DelMellomida/kai/requirements.lock.txt

# Generated by scripts/freeze_requirements.sh on 2026-08-07T12:01:05+08:00
# Host: Linux 5.15.148-tegra aarch64  |  Python 3.10.12
#
# ⚠️  Lines marked [JETSON-BUILT] must NOT be reinstalled from PyPI — they are either
#     hand-built with CUDA or provided by JetPack. Restoring them from this file with a
#     plain 'pip3 install -r' will give you a CPU-only build.
#
absl-py==2.4.0
annotated-doc==0.0.4
anyio==4.13.0
appdirs==1.4.4
apturl==0.5.2
async-timeout==5.0.1
attrs==21.2.0
av==17.1.0
backports.asyncio.runner==1.2.0
bcrypt==3.2.0
beniget==0.4.1
bleak==3.0.2
blinker==1.9.0
bluez_peripheral==0.2.0a5
Brlapi==0.8.3
Brotli==1.0.9
certifi==2026.6.17
cffi==2.0.0
chardet==4.0.0
charset-normalizer==3.4.7
click==8.4.1
colorama==0.4.4
coloredlogs==15.0.1
coverage==7.14.1
cpuset==1.6
cryptography==3.4.8
ctranslate2==4.8.0
cupshelpers==1.0
cycler==0.11.0
Cython==3.2.5
dbus-fast==5.0.22
dbus-python==1.2.18
decorator==4.4.2
defer==1.0.6
distro==1.7.0
distro-info==1.1+ubuntu0.2
dnspython==2.1.0
duplicity==0.8.21
exceptiongroup==1.3.1
fastembed==0.8.0
fasteners==0.14.1
faster-whisper==1.2.1
filelock==3.29.0
Flask==3.1.3
flatbuffers==25.12.19
fonttools==4.29.1
fs==2.4.12
fsspec==2026.4.0
future==0.18.2
gast==0.5.2
gpg==1.16.0
h11==0.16.0
hf-xet==1.5.0
httpcore==1.0.9
httplib2==0.20.2
httpx==0.28.1
huggingface_hub==1.18.0
humanfriendly==10.0
idna==3.3
importlib-metadata==4.6.4
iniconfig==2.3.0
itsdangerous==2.2.0
jax==0.6.2
jaxlib==0.6.2
jeepney==0.7.1
jetson-stats==4.3.2    # [JETSON-BUILT] do not reinstall from PyPI
Jetson.GPIO==2.1.7
Jinja2==3.1.6
joblib==1.5.3
keyring==23.5.0
kiwisolver==1.3.2
language-selector==0.1
launchpadlib==1.10.16
lazr.restfulclient==0.14.4
lazr.uri==1.0.6
lockfile==0.12.2
loguru==0.7.3
louis==3.20.0
lxml==4.8.0
lz4==3.1.3+dfsg
macaroonbakery==1.3.1
Mako==1.1.3
Markdown==3.3.6
markdown-it-py==4.2.0
MarkupSafe==3.0.3
matplotlib==3.5.1
mdurl==0.1.2
mediapipe==0.10.18
ml_dtypes==0.5.4
mmh3==5.2.1
monotonic==1.6
more-itertools==8.10.0
mpmath==1.3.0
networkx==3.4.2
numpy==1.26.4
oauthlib==3.2.0
olefile==0.46
onboard==1.4.1
onnxruntime==1.23.2
opencv-contrib-python==4.11.0.86
opencv-python==4.11.0.86
openwakeword==0.6.0
opt_einsum==3.4.0
packaging==26.2
pandas==1.3.5
paramiko==2.9.3
pathvalidate==3.3.1
pexpect==4.8.0
pillow==12.3.0
piper-tts==1.4.2
pluggy==1.6.0
ply==3.11
polars==1.41.2
polars-runtime-32==1.41.2
protobuf==4.25.9
psutil==7.2.2
ptyprocess==0.7.0
pvporcupine==4.0.3
py-spy==0.4.2
py_rust_stemmers==0.1.8
pycairo==1.20.1
pycparser==3.0
pycups==2.0.1
Pygments==2.20.0
PyGObject==3.42.1
PyJWT==2.3.0
pymacaroons==0.13.0
PyNaCl==1.5.0
PyOpenGL==3.1.5
pyparsing==2.4.7
pypdf==6.14.2
pyRFC3339==1.1
pyserial==3.5
pytest==9.0.3
pytest-asyncio==1.4.0
pytest-cov==7.1.0
pytest-mock==3.15.1
python-apt==2.4.0+ubuntu4.1
python-dateutil==2.8.1
python-dbusmock==0.27.5
python-debian==0.1.43+ubuntu1.1
python-dotenv==1.2.2
pythran==0.10.0
pytz==2022.1
pyxdg==0.27
PyYAML==5.4.1
requests==2.34.2
requests-toolbelt==0.9.1
rich==15.0.0
scikit-learn==1.7.2
scipy==1.15.3
SecretStorage==3.3.1
sentencepiece==0.2.1
# Editable install with no version control (sentient-face==0.1.0)
-e /home/devconph/Documents/sentient-face
shellingham==1.5.4
six==1.16.0
smbus2==0.6.1
sounddevice==0.5.5
sympy==1.13.1
systemd-python==234
tensorrt==10.3.0    # [JETSON-BUILT] do not reinstall from PyPI
tensorrt_dispatch==10.3.0    # [JETSON-BUILT] do not reinstall from PyPI
tensorrt_lean==10.3.0    # [JETSON-BUILT] do not reinstall from PyPI
threadpoolctl==3.6.0
tokenizers==0.23.1
tomli==2.4.1
torch @ file:///home/devconph/torch-2.5.0a0%2B872d972e41.nv24.08.17622132-cp310-cp310-linux_aarch64.whl    # [JETSON-BUILT] do not reinstall from PyPI
torchvision==0.20.0    # [JETSON-BUILT] do not reinstall from PyPI
tqdm==4.68.1
typer==0.25.1
typing_extensions==4.15.0
ubuntu-drivers-common==0.0.0
ubuntu-pro-client==8001
ufoLib2==0.13.1
ultralytics==8.4.57
ultralytics-thop==2.0.19
unicodedata2==14.0.0
urllib3==1.26.5
urwid==2.1.2
wadllib==1.3.6
webrtcvad==2.0.10
Werkzeug==3.1.8
xdg==5
xkit==0.0.0
zipp==1.0.0
