DelMellomida/kai/documents/devcon_faq_rag.md

# DEVCON PH — Knowledge Base (RAG)

---
id: about-what-is
section: About DEVCON
synonyms: [what is DEVCON, DEVCON meaning, who are you, organization overview, mission, vision, purpose, goal, what is DEVCON trying to achieve, what DEVCON stands for]
---
**Q: What is DEVCON Philippines?**
A: DEVCON (Developers Connect), registered as DevConnect Philippines Inc., is a non-profit and the largest volunteer community of software developers and tech future makers in the Philippines. Its vision is a technology-empowered Philippines for all, and its mission is to build vibrant developer communities empowered with knowledge, open-source software, and opportunities to solve impactful national problems.

---
id: about-history
section: About DEVCON
synonyms: [origin, founding, how it began, PSIA, first event]
---
**Q: When and how did DEVCON start?**
A: DEVCON began in 2009 as a project of the Philippine Software Industry Association (PSIA), piloting with DEVCON Visayas at the TechBar in Cebu City. It grew into a ten-city Next Wave Cities tour, partnered with the Philippine Society of IT Educators (PSITE) to reach students, and later registered with the SEC as a non-profit.

---
id: about-scale
section: About DEVCON
synonyms: [size, reach, how many participants, total members]
---
**Q: How big is DEVCON?**
A: DEVCON has reached over 60,000 participants since June 2009 through free conferences, summits, hackathons, workshops, and meetups. It operates active chapters nationwide across Luzon, Visayas, and Mindanao.

---
id: about-leadership
section: About DEVCON
synonyms: [who leads, head, CEO, in charge]
---
**Q: Who leads DEVCON?**
A: DEVCON's founder and president is Winston Damarillo.

---
id: about-anniversary
section: About DEVCON
synonyms: [this year, theme, 17 years, AIReadyPH]
---
**Q: What is DEVCON celebrating this year?**
A: DEVCON is marking its 17th anniversary under the theme "17 Years of DEVCON: Engineering an AI-Ready Nation" (#AIReadyPH). Its current focus is democratizing access to AI for all Filipinos.

---
id: about-online
section: About DEVCON
synonyms: [website, contact, links, social media, find you]
---
**Q: Where can I find DEVCON online?**
A: DEVCON is at devcon.ph, with chapters listed at devcon.ph/chapters and its community platform at devcon.plus.

---
id: chapters-count
section: Chapters
synonyms: [how many chapters, number of chapters, how many active, chapter count, how many branches, ilan ang chapters]
---
**Q: How many chapters does DEVCON have?**
A: DEVCON has 9 active chapters — Metro Manila, Laguna, Legazpi, Pampanga, Cebu, Iloilo, Davao, Bukidnon, and Iligan — out of 12 in total. Bacolod, Bohol, and Cagayan de Oro (CDO) are currently inactive but retain volunteer-led communities.

---
id: chapters-locations
section: Chapters
synonyms: [where are chapters, cities, branches, active inactive]
---
**Q: Where are DEVCON's chapters?**
A: DEVCON runs active chapters across Luzon, Visayas, and Mindanao — including Metro Manila, Laguna, Legazpi, Pampanga, Cebu, Iloilo, Davao, Bukidnon, and Iligan. Bacolod, Bohol, and Cagayan de Oro (CDO) are currently inactive but retain volunteer-led communities. DEVCON describes its network as "real geography, not a map graphic," reaching towns like Tacloban that a single Manila event never could.

---
id: chapters-size
section: Chapters
synonyms: [chapter membership, how many members per chapter, biggest chapter]
---
**Q: How big are the individual chapters?**
A: Approximate chapter sizes: Metro Manila 5.4K+, Davao 5.8K+, CDO 4K+ (inactive), Cebu 3.4K+, Iloilo 2.6K+, Laguna 1.4K+, Bukidnon 1.4K+, Bacolod 1.3K+ (inactive), Legazpi 980+, Iligan 890+, Pampanga 630+, and Bohol 560+ (inactive).

---
id: chapters-start
section: Chapters
synonyms: [start a chapter, open a branch, new chapter, become organizer]
---
**Q: Can I start a chapter in my area?**
A: Yes. DEVCON actively invites local tech leaders to start and sustain chapters. Interested leaders can reach out through devcon.ph/chapters.

---
id: programs-overview
section: Programs
synonyms: [what programs, initiatives, offerings, activities]
---
**Q: What programs does DEVCON run?**
A: DEVCON's programs span education, emerging tech, and community: Nationwide Chapters (local events, workshops, meetups); DEVCON Summits (keynotes, workshops, hackathons); DEVCON Code Camps (hands-on coding for beginners); Campus DEVCON (university program with an Ambassador track); DEVCON Kids (coding for young learners in underserved communities, with CSTA Philippines); #SHEISDEVCON (girls and women in tech); DCTX / Community of Tech Experts (open-source and social-impact projects from pandemic work with USAID, IATF, DSWD); DEVCON for Educators (teacher support and resources); and DEVCON CREST (Climate Resilience Technology).

---
id: programs-devconplus
section: Programs
synonyms: [DEVCON+, devcon.plus, points, rewards, jobs platform, volunteer]
---
**Q: What is DEVCON+?**
A: DEVCON+ (devcon.plus) is DEVCON's community platform where participation pays off — members volunteer, earn points, and find jobs in one place. It turns community involvement into something tangible, and is where trainings, scholarships, and internship openings are posted first.

---
id: kai-what
section: Kai (robot)
synonyms: [Kai robot, what is Kai, who built Kai]
---
**Q: What is Kai?**
A: Kai is a robot assembled by DEVCON Manila chapter volunteers and built by the DEVCON Jumpstart Cohort 4 AI Engineering Interns.

---
id: kai-how
section: Kai (robot)
synonyms: [how Kai works, Jetson, face tracking, edge computing, on-device]
---
**Q: How does Kai work?**
A: Kai runs on an NVIDIA Jetson Orin Nano behind a cardboard face, processing all AI workloads on-device with no cloud round trips. Its camera runs MediaPipe FaceMesh at 320x240 for face tracking; camera feed, computer-vision inference, and mirroring motor responses all run locally in real time — an example of edge computing. Its neck servo pans up to 180 degrees.

---
id: kai-hardware
section: Kai (robot)
synonyms: [what powers Kai, offline, NVIDIA Ampere, CUDA, TensorRT, barangay]
---
**Q: What powers Kai?**
A: Kai is built on NVIDIA Ampere architecture with Tensor Cores, using the CUDA ecosystem and TensorRT for near-zero-latency neural network execution. It runs fully offline, so it works anywhere — from a smart city to a far-flung barangay with no stable internet.

---
id: kai-stack
section: Kai (robot)
synonyms: [Kai tech stack, tools behind Kai, NMBLR.AI, what software runs Kai, what model do you use, Arduino, Gemma, Whisper, Piper, Ollama, MediaPipe, open source]
---
**Q: What's the tech stack behind Kai?**
A: Kai runs on an NVIDIA Jetson Orin Nano lent by the NMBLR.AI team, and its code was written with Claude Code. MediaPipe tracks the face, Whisper turns speech into text, Gemma 2 answers through Ollama, and Piper speaks the reply. An Arduino drives the neck and jaw servos, and a small local search index lets Kai answer from its own documents. All of it runs on the robot itself — nothing goes to the cloud.

---
id: internship-what
section: Jumpstart Internship
synonyms: [what is the internship, Jumpstart, AI Engineering internship, Cohort 4]
---
**Q: What is the DEVCON Jumpstart Internship?**
A: The DEVCON Jumpstart Internship is an internship with the Philippines' largest tech non-profit, working on national-scale, mission-driven projects using a modern stack of Claude Code, Google AI, and Sui Smart Contracts, alongside industry AI practitioners. It puts top students on an AI Engineering track mentored by working engineers. Cohort 4 is currently running with members from Manila, Iloilo, and CDO in a flexible hybrid setup, and past cohorts have come out of Iloilo and CDO.

---
id: internship-tracks
section: Jumpstart Internship
synonyms: [tracks, modules, specialization, focus areas]
---
**Q: What tracks or modules can I specialize in?**
A: Internship tracks include AI Engineering, Blockchain Smart Contracts, Creative Robotics Education, Studios Content & Creatives, Project Management & Agentic QA, Entrepreneurship & Product Management, Design & Digital Marketing, Enterprise Data Cloud, and Full Stack Development. Each intern picks a top 2; final assignment is based on assessed skills, team dynamics, and cohort needs.

---
id: internship-paid
section: Jumpstart Internship
synonyms: [paid, salary, stipend, compensation, money]
---
**Q: Is the internship paid?**
A: DEVCON provides transportation and communication allowances to support participation in the internship.

---
id: internship-time
section: Jumpstart Internship
synonyms: [time commitment, hours, schedule, how often]
---
**Q: What is the time commitment for the internship?**
A: The internship is a flexible hybrid setup blending asynchronous learning with 1–2 in-person sessions per week, plus expert talks, events, and mentorship.

---
id: internship-location
section: Jumpstart Internship
synonyms: [where, office, venue, in-person location]
---
**Q: Where are the internship's in-person meetings held?**
A: In-person sessions are held at DEVCON's Pasig office, with additional on-site and exclusive tech events throughout the program.

---
id: internship-structure
section: Jumpstart Internship
synonyms: [program structure, format, components, what to expect]
---
**Q: What does the internship program structure look like?**
A: The internship has five components — flexible asynchronous learning; in-person sessions (1–2 per week); on-site and exclusive tech events; guest speaker "Ask Me Anything" sessions; and transportation/communication allowances.

---
id: internship-projects
section: Jumpstart Internship
synonyms: [projects, what will I build, deployable, real-world]
---
**Q: What kind of projects will interns work on?**
A: Interns work on real-world, deployable projects tackling challenges like climate resilience and tech education. For example, past interns built "Flood Detection with Flood Alarms" using sensors and real-time data analysis for disaster preparedness.

---
id: internship-benefits
section: Jumpstart Internship
synonyms: [benefits, what do I get, perks, beyond skills]
---
**Q: What do interns get beyond technical skills?**
A: Beyond technical skills, interns get portfolio-ready outputs for job applications, world-class mentorship, a nationwide professional network, special recognition, and growth in teamwork, communication, and problem-solving.

---
id: internship-eligibility
section: Jumpstart Internship
synonyms: [who can apply, eligibility, requirements, competitive, students]
---
**Q: Who can apply to the internship and how competitive is it?**
A: The internship is open to standout AI Engineering and tech talent, largely IT, Computer Science, and Computer Engineering students. Slots are limited with a competitive selection process, so applications should show why the applicant is a strong fit.

---
id: internship-network
section: Jumpstart Internship
synonyms: [network, community, mentors, peers, chapters connection]
---
**Q: What network and community will interns be part of?**
A: Interns connect with DEVCON's nationwide chapters — including Iloilo, Cebu, Pampanga, Bukidnon, and beyond — working directly with leaders and a supportive community of mentors and peers.

---
id: ai-tools
section: AI Programs
synonyms: [what tools, AI tooling, hands-on, Claude, real tools]
---
**Q: What AI tools do DEVCON program participants use?**
A: DEVCON participants train with real, current AI tooling — including Claude — rather than toy examples, so what they learn transfers directly to real engineering work.

---
id: ai-scholarship-what
section: AI Programs
synonyms: [AI Scholarship, certification, funded exam, scholarship for developers]
---
**Q: What is the DEVCON AI Scholarship for Developers?**
A: The AI Scholarship is a program to take developers from learning to earning: review, get certified, and get connected directly to AI engineering gigs. Tied to the 17th anniversary, it supports high-potential builders with structured prep and funded certification exam slots. Per the application materials, a funded slot requires completing review within 1–2 months and passing a mock exam at least three times.
Note: The application materials reference specific "Claude Certified" tracks and a third-party reviewer link that could not be verified as official Anthropic credentials or an official DEVCON resource; these are excluded pending confirmation.

---
id: ai-scholarship-apply
section: AI Programs
synonyms: [how to apply scholarship, reviewer form, email, ai@devcon.ph]
---
**Q: How do I apply for the AI Scholarship?**
A: Per the application materials, applicants complete the reviewer form and email proof of passing to ai@devcon.ph. (Unverified — as stated in application materials; see the scholarship overview note.)

---
id: ai-fluency-training
section: AI Programs
synonyms: [AI Fluency, leadership training, chapter leaders, orchestrators]
---
**Q: What are AI Fluency Leadership Trainings?**
A: AI Fluency Leadership Trainings prepare chapter leaders to become AI orchestrators in their own regions, turning local leadership into local AI capability rather than top-down instruction. They piloted in Luzon and are expanding into Mindanao.

---
id: pov-stance
section: DEVCON's POV on AI
synonyms: [stance on AI, view on AI, position, philosophy]
---
**Q: What is DEVCON's overall stance on AI?**
A: DEVCON views AI as the biggest opportunity Filipino developers have had in a generation — not something to fear or wait out. Its POV: don't just consume AI, build with it. DEVCON believes the nation that learns fastest and builds boldest wins the next decade.

---
id: pov-replace-devs
section: DEVCON's POV on AI
synonyms: [will AI replace developers, job loss, automation fear]
---
**Q: Is DEVCON worried AI will replace developers?**
A: No. DEVCON believes AI changes what a developer's job looks like, not whether developers are needed. The winners will be those who orchestrate AI rather than resist it, and DEVCON's job is to make sure every Filipino geek is in that group.

---
id: pov-ph-positioning
section: DEVCON's POV on AI
synonyms: [why Philippines, advantage, well-positioned, BPO, Bayanihan, STEM]
---
**Q: Why does DEVCON think the Philippines is well-positioned for AI?**
A: DEVCON points to three things stacked together that are rare in the region: decades of service-industry DNA from BPO, 700,000+ STEM graduates a year, and a culture of Bayanihan — collective effort as a competitive advantage. DEVCON argues that combination is exactly what the AI era rewards.

---
id: pov-ai-ready-meaning
section: DEVCON's POV on AI
synonyms: [Engineering an AI-Ready Nation meaning, what does AI-ready mean]
---
**Q: What does "Engineering an AI-Ready Nation" mean?**
A: To DEVCON it means readiness is not a slogan but concrete action — chapters, trainings, internships, and tools reaching real developers in real towns, not just a keynote in a Manila ballroom. It frames the effort as nation-building, one chapter at a time.

---
id: pov-behind-or-not
section: DEVCON's POV on AI
synonyms: [is Philippines behind, adoption gap, 85%, lagging]
---
**Q: Does DEVCON think the Philippines is behind in AI?**
A: DEVCON reframes it: the gap is the opportunity. Roughly 85% of Philippine businesses have not adopted AI yet, and DEVCON sees each of those gaps as a company waiting for a founder — a runway, not a deficit.

---
id: ambition-goal
section: DEVCON's Ambition
synonyms: [big goal, mission, audacious goal, lead Southeast Asia]
---
**Q: What is DEVCON's big goal for AI in the Philippines?**
A: DEVCON's ambition is to help the Philippines lead Southeast Asia's AI era rather than catch up to it — setting its own timeline instead of chasing Silicon Valley's.

---
id: ambition-leading-looks-like
section: DEVCON's Ambition
synonyms: [what leading looks like, forward-deployed, micro companies, ecosystems]
---
**Q: What does "leading" Southeast Asia in AI look like in practice?**
A: DEVCON describes three things happening at once: Filipino engineers embedded inside businesses everywhere as forward-deployed talent, a wave of solo-builder-plus-AI-agent micro companies born global, and Bayanihan ecosystems where geeks and business builders share playbooks instead of guarding them.

---
id: ambition-fde
section: DEVCON's Ambition
synonyms: [Forward-Deployed Engineer, FDE, enterprise AI role, most in-demand role]
---
**Q: What is a "Forward-Deployed Engineer" (FDE) and why does DEVCON care?**
A: An FDE embeds inside a business and makes AI actually work for it — arguably the most in-demand role in enterprise AI today. DEVCON notes it closely matches the skills Filipino talent has built through decades of service and support work, and DEVCON wants its geeks to own this role globally.

---
id: ambition-micro-companies
section: DEVCON's Ambition
synonyms: [one big company or many, unicorn, million micro companies, solo builder]
---
**Q: Does DEVCON want to build one big AI company or something else?**
A: Something else, deliberately. DEVCON's ambition is a million micro companies — one builder plus AI agents — rather than betting everything on a single unicorn, on the view that distributed wins compound across a nation.

---
id: ambition-youth
section: DEVCON's Ambition
synonyms: [youth goal, DEVCON Kids 2026, 10000 youth, education ambition]
---
**Q: What is the youth / AI-education piece of DEVCON's ambition?**
A: DEVCON's 2026 goal is to empower 10,000 youth through DEVCON Kids, on the view that AI readiness is generational, not just a workforce issue. DEVCON Kids is how it starts AI fluency young rather than only training adults playing catch-up.

---
id: ambition-community-size
section: DEVCON's Ambition
synonyms: [how big community, 19000 geeks, 9 chapters, 120 events, growth target]
---
**Q: How big does DEVCON want its AI-ready community to get?**
A: DEVCON is already at 9 active chapters, roughly 19,000 geeks, and 120+ free events a year, within a wider 60,000+ nationwide network. Its ambition emphasizes deeper reach into places a single Manila event could never touch, not just bigger numbers.

---
id: ambition-partners
section: DEVCON's Ambition
synonyms: [can DEVCON do it alone, partners, collaboration, Bayanihan]
---
**Q: Can DEVCON pull off this AI ambition alone?**
A: No, and it doesn't intend to. DEVCON says it takes trusted partners, chapter volunteers, and thousands of developers choosing to build instead of wait — because Bayanihan only works when it's collective.

---
id: exciting-speed
section: What's Exciting About AI
synonyms: [what excites DEVCON, most exciting, speed, learning advantage]
---
**Q: What excites DEVCON most about AI right now?**
A: Speed — the speed at which someone with almost no resources can now ship something real. DEVCON sees learning speed as the new competitive advantage, faster than capital or pedigree.

---
id: exciting-problems
section: What's Exciting About AI
synonyms: [national problems, typhoon forecasting, food security, climate resilience]
---
**Q: What real-world problems is DEVCON excited about AI solving in the Philippines?**
A: DEVCON highlights national-scale problems: typhoon forecasting that gives people minutes instead of hours of warning, food security through optimized harvests for 110 million Filipinos, and climate resilience for one of the most climate-exposed nations on earth — live problems its community can work on today.

---
id: exciting-juniors
section: What's Exciting About AI
synonyms: [students, junior developers, barrier to entry, beginners]
---
**Q: What's exciting about AI for junior or student developers?**
A: DEVCON points out the barrier to building something real has never been lower — you no longer need years of experience to ship a working product, just curiosity, speed, and a willingness to start small and start now.

---
id: exciting-entrepreneurship
section: What's Exciting About AI
synonyms: [entrepreneurship, startups, solo founder, AI agents team]
---
**Q: What excites DEVCON about AI and entrepreneurship?**
A: DEVCON is excited that a single builder paired with AI agents can now do the work that used to take a small team, shifting who gets to start a company — no longer gated by headcount or capital.

---
id: exciting-skepticism
section: What's Exciting About AI
synonyms: [skeptical, AI hype, wary, spectacle, criticism]
---
**Q: Is there anything about AI hype DEVCON is skeptical of?**
A: Yes. DEVCON is wary of AI as spectacle — one expensive summit or keynote with no follow-through. Its focus is sustained, grassroots capability building rather than moments.

---
id: involved-developer
section: How to Get Involved
synonyms: [I'm a developer, how to join, plug in, get started dev]
---
**Q: I'm a developer — how do I plug into DEVCON's AI push?**
A: Start with your nearest chapter or DEVCON+ (devcon.plus), where trainings, scholarships, and internship openings get posted first.

---
id: involved-student
section: How to Get Involved
synonyms: [I'm a student, where to start, student entry point]
---
**Q: I'm a student — where do I start with DEVCON's AI programs?**
A: Watch for the next Jumpstart Internship cohort and get involved with your local chapter's events. Past interns came in as students and came out with real, mentored engineering experience.

---
id: involved-business
section: How to Get Involved
synonyms: [I run a business, employer, sponsor, hire talent, partner]
---
**Q: I run a business — how does DEVCON's AI ambition involve me?**
A: Businesses are part of the 85% opportunity gap and core to closing it — whether by hiring DEVCON-trained talent, sponsoring a chapter, or partnering on a real-world problem.

---
id: involved-takeaway
section: How to Get Involved
synonyms: [one takeaway, key message, what should every developer know]
---
**Q: What's the one thing DEVCON wants every Filipino developer to take away about AI?**
A: That the AI decade is theirs to build, not just use — create instead of only consuming, start small and start now, learn faster than anyone else, and build it with Bayanihan, because the Philippines doesn't need to catch up to lead.
