DelMellomida/kai/tests/test_rag.py

import json
import unittest
from unittest.mock import MagicMock, patch

import numpy as np

from ai import rag


class TestChunkText(unittest.TestCase):
    def test_empty_string_returns_empty_list(self):
        self.assertEqual(rag.chunk_text(""), [])

    def test_short_text_returns_single_chunk(self):
        text = "hello world"
        self.assertEqual(rag.chunk_text(text, chunk_size=800, overlap=150), [text])

    def test_long_text_produces_multiple_chunks(self):
        text = "a" * 2000
        chunks = rag.chunk_text(text, chunk_size=800, overlap=150)
        self.assertGreater(len(chunks), 1)
        for c in chunks:
            self.assertLessEqual(len(c), 800)

    def test_overlap_shares_content_between_chunks(self):
        text = "0123456789" * 200  # 2000 chars
        chunks = rag.chunk_text(text, chunk_size=800, overlap=150)
        # end of chunk[0] should reappear at the start of chunk[1]
        self.assertEqual(chunks[0][-150:], chunks[1][:150])

    def test_covers_full_text(self):
        text = "x" * 1700
        chunks = rag.chunk_text(text, chunk_size=800, overlap=150)
        self.assertTrue("".join(chunks).endswith("x" * 100))
        self.assertEqual(chunks[-1][-1], "x")


class TestCosineSimilarity(unittest.TestCase):
    def test_identical_vectors(self):
        a = np.array([1.0, 2.0, 3.0])
        self.assertAlmostEqual(rag.cosine_similarity(a, a), 1.0)

    def test_orthogonal_vectors(self):
        a = np.array([1.0, 0.0])
        b = np.array([0.0, 1.0])
        self.assertAlmostEqual(rag.cosine_similarity(a, b), 0.0)

    def test_opposite_vectors(self):
        a = np.array([1.0, 0.0])
        b = np.array([-1.0, 0.0])
        self.assertAlmostEqual(rag.cosine_similarity(a, b), -1.0)

    def test_zero_vector_returns_zero(self):
        a = np.array([0.0, 0.0])
        b = np.array([1.0, 1.0])
        self.assertEqual(rag.cosine_similarity(a, b), 0.0)


class TestRankChunks(unittest.TestCase):
    def setUp(self):
        rag._INDEX_CHUNKS = [
            {"source": "a.txt", "text": "close match"},
            {"source": "b.txt", "text": "far match"},
            {"source": "c.txt", "text": "irrelevant"},
        ]
        # Deliberately spread apart: these tests are about score ordering and the threshold, so
        # the vectors must not also be near-duplicates of each other or MMR_MAX_SIMILARITY would
        # be the thing under test. Diversity has its own case in TestResultDiversity.
        rag._INDEX_VECTORS = np.array([
            [1.0, 0.0],
            [0.7, 0.7],
            [-1.0, 0.0],
        ])

    def tearDown(self):
        rag._INDEX_CHUNKS = []
        rag._INDEX_VECTORS = None

    def test_returns_top_k_sorted_descending(self):
        results = rag.rank_chunks([1.0, 0.0], threshold=-1.0, top_k=2)
        self.assertEqual(len(results), 2)
        self.assertEqual(results[0]["source"], "a.txt")

    def test_excludes_below_threshold(self):
        results = rag.rank_chunks([1.0, 0.0], threshold=0.5, top_k=3)
        sources = [c["source"] for c in results]
        self.assertNotIn("c.txt", sources)

    def test_no_index_returns_empty(self):
        rag._INDEX_CHUNKS = []
        rag._INDEX_VECTORS = None
        self.assertEqual(rag.rank_chunks([1.0, 0.0]), [])


class TestPrimerCap(unittest.TestCase):
    """Measured after the reindex: one dense on-brand fact per line is the ideal shape for this
    embedder, so primer lines took all three slots on "what is DEVCON?" and crowded out the
    document that answered the specific question. Barring it entirely overcorrected."""

    def setUp(self):
        rag._INDEX_CHUNKS = [
            {"source": rag.PRIMER_SOURCE, "text": "primer line one"},
            {"source": rag.PRIMER_SOURCE, "text": "primer line two"},
            {"source": rag.PRIMER_SOURCE, "text": "primer line three"},
            {"source": "programs.md", "text": "the specific answer"},
        ]
        # Spread apart for the same reason as TestRankChunks — the primer cap is what is under
        # test here, not the diversity filter. Score order stays primer one > two > answer >
        # three, and every pair sits under MMR_MAX_SIMILARITY.
        rag._INDEX_VECTORS = np.array([[1.0, 0.0], [0.9, 0.436], [0.3, 0.954], [0.6, 0.8]])

    def tearDown(self):
        rag._INDEX_CHUNKS = []
        rag._INDEX_VECTORS = None

    def test_primer_keeps_its_capped_slots_and_gives_the_rest_away(self):
        results = rag.rank_chunks([1.0, 0.0], threshold=-1.0, top_k=3)
        sources = [c["source"] for c in results]
        self.assertEqual(sources.count(rag.PRIMER_SOURCE), rag.PRIMER_MAX_IN_RANKING)
        self.assertIn("the specific answer", [c["text"] for c in results])

    def test_the_slot_goes_to_the_primers_best_line(self):
        # Applied after the sort: the cap must not drop the primer to wherever top_k lands.
        results = rag.rank_chunks([1.0, 0.0], threshold=-1.0, top_k=3)
        self.assertEqual(results[0]["text"], "primer line one")

    def test_the_last_resort_injection_uses_its_own_cap(self):
        # primer_chunks() bypasses ranking — when it fires, retrieval has already found nothing
        # and there is nothing left to crowd out, so PRIMER_MAX_CHUNKS governs and
        # PRIMER_MAX_IN_RANKING must not. This used to assert the injection was simply LARGER,
        # which stopped saying anything when PRIMER_MAX_CHUNKS came down to 2 (a Q&A entry is
        # several times the size of the one-line primer facts the old number was chosen for) and
        # the two knobs happened to meet. Asserting which knob applies is the real invariant.
        self.assertEqual(len(rag.primer_chunks()), rag.PRIMER_MAX_CHUNKS)

    def test_the_primer_is_matched_by_section_as_well_as_filename(self):
        # The primer moved from its own file into a section of the one knowledge base; a
        # filename-only test silently matched nothing and took the whole failsafe offline.
        rag._INDEX_CHUNKS = [{"source": "devcon_faq_rag.md", "section": rag.PRIMER_SECTION,
                              "text": "DEVCON is a non-profit."}]
        self.assertEqual(len(rag.primer_chunks()), 1)


class TestResultDiversity(unittest.TestCase):
    """Measured on the 505-chunk index: 1347 chunk pairs sit above cosine 0.97, and 4 of the 16
    eval queries returned two chunks above 0.90 similar to each other. At TOP_K=3 in a 1024-token
    context, a chunk that restates its neighbour costs a third of everything Kai gets to see."""

    def setUp(self):
        rag._INDEX_CHUNKS = [
            {"source": "a.md", "text": "DEVCON has 11 active chapters nationwide"},
            {"source": "a.md", "text": "DEVCON has eleven active chapters nationwide"},
            {"source": "b.md", "text": "DEVCON was founded in 2009"},
        ]
        # First two are restatements (cos 0.999); the third is a different fact.
        rag._INDEX_VECTORS = np.array([[1.0, 0.0], [0.999, 0.045], [0.6, 0.8]])

    def tearDown(self):
        rag._INDEX_CHUNKS = []
        rag._INDEX_VECTORS = None

    def test_a_restatement_does_not_spend_a_slot(self):
        results = rag.rank_chunks([1.0, 0.0], threshold=-1.0, top_k=3)
        texts = [c["text"] for c in results]
        self.assertIn("DEVCON has 11 active chapters nationwide", texts)
        self.assertNotIn("DEVCON has eleven active chapters nationwide", texts)

    def test_the_freed_slot_goes_to_a_different_fact(self):
        results = rag.rank_chunks([1.0, 0.0], threshold=-1.0, top_k=2)
        self.assertEqual([c["text"] for c in results][1], "DEVCON was founded in 2009")

    def test_distinct_chunks_are_all_kept(self):
        # Mutually far apart — 0.0 to 0.707 pairwise, nowhere near MMR_MAX_SIMILARITY.
        rag._INDEX_VECTORS = np.array([[1.0, 0.0], [0.7, 0.7], [0.0, 1.0]])
        self.assertEqual(len(rag.rank_chunks([1.0, 0.0], threshold=-1.0, top_k=3)), 3)
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
