DelMellomida/kai/(commit log)

2026-08-09 Initial public release of Kai
    Kai is a small companion robot built by DEVCON Philippines: a Jetson Orin Nano
    that tracks a face with a camera and servo neck, listens for "Hey Kai", answers
    questions about DEVCON from a local RAG corpus, and speaks the reply aloud.
    Everything runs on-device — Whisper for speech-to-text, Ollama/gemma2 for the
    reply, Piper for text-to-speech, MediaPipe for face tracking. No cloud, no API
    keys, no runtime internet.
    Model weights and vendored binaries are not checked in (~3 GB); scripts/ fetches
    them. The RAG embedding index is generated by ai/index_documents.py.
2026-08-09 Extract process lifecycle into app/lifecycle.py
    face_track.py held four unrelated jobs in one namespace; this takes out the
    first of them. The instance lock, the SIGTERM/SIGHUP handlers, the restart
    path (schedule -> signal -> forced deadline) and the reboot probe are all
    about the PROCESS, not the robot: they touch no camera, no servo, no mic and
    no conversation state, so they belong behind their own import and can now be
    exercised without pulling MediaPipe in.
    Names lose their leading underscore on the way out — they are a module API
    now rather than file-private helpers — and callers go through the module
    (lifecycle.reboot_now()) rather than importing the functions, so patching one
    in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
    [face_track.py, lifecycle.py, test_web.py]
2026-08-09 Extract the camera supervisor into app/camera_supervisor.py
    Second of face_track.py's four jobs. The probe/acquire/release loop, the swap
    queue, the "probe now" event and the lock-guarded state dict the dashboard
    reads were seven module-level globals and six functions mutating them through
    `global` statements; they are now one CameraSupervisor object with the state
    private behind set_state()/snapshot().
    This is the piece that made the camera hot-pluggable, and it was the hardest
    part of face_track.py to reason about precisely because its state was spread
    across the same namespace as the web publisher and the control loop — nothing
    stopped either of them touching _cam_live. Now the only wa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
    [camera_supervisor.py, face_track.py, test_web.py]
2026-08-09 Extract the dashboard into web/ (state + Flask app)
    Third of face_track.py's four jobs, and the largest. web/ held only HTML while
    the 15 routes serving it lived 1400 lines up in the entry point, next to the
    MediaPipe loop.
    web/state.py DashboardState — the seven _web_* globals behind one object.
    Knows nothing about cameras, servos or MediaPipe: callers
    hand it finished dicts. The stale-frame expiry moved in with
    it, because "status arrived without a frame for
    FRAME_STALE_S" is a fact about the two halves' relationship,
    not about the tracking loop.
    web/server.py Dashboard.create_app(). Ever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
2026-08-09 Extract the servo control thread into app/control_loop.py
    Last of face_track.py's four jobs to come out on its own. The control loop and
    the thinking-sweep maths are ~160 lines that share nothing with the inference
    loop except a TrackingTarget, which is exactly the point of the decoupling
    they implement.
    The loop read the module-global _voice to spot the thinking window; it now
    takes the assistant as a parameter, so the thread's whole input set is visible
    in its signature: servo, target, voice, stop event.
    The three sweep functions lose their leading underscore — they are the module
    API now, and tests/test_thinking.py sweeps their entire random parameter space.
    That test no longer import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
    [control_loop.py, face_track.py, test_thinking.py]
2026-08-09 Extract mic discovery into ai/mic_device.py
    Fixes a layering inversion. ai/session.py imported apply_i2s_route,
    free_i2s_device, resolve_input_device and resume_pulse_source FROM
    ai/voice_assistant.py — so the module that owns the shared always-open capture
    stream depended on the module that owns the LEGACY per-turn one, for plumbing
    neither of them is really about. Both are now consumers of a lower layer.
    What moved is device plumbing, not conversation: ALSA mixer routes, PulseAudio
    suspend/resume, the liveness probe, device ranking, and the rate arithmetic
    that keeps Decimator constructible. It needs sounddevice and subprocess and
    nothing else from ai/ — no Whisper, no Ollama, no TTS.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
    [test_mic_device.py, test_voice_assistant.py]
2026-08-09 Split three lower layers out of ai/voice_assistant.py
    VoiceAssistant is a class about mic state, turn epochs and the threads that
    carry a turn. Three things inside the same file were none of those:
    ai/llm.py an HTTP client for Ollama — the persona file, prompt
    assembly, the request, and the timing numbers that
    separate a slow prompt from slow generation from a
    model that got reloaded onto CPU
    ai/transcript.py pure gates deciding whether a Whisper transcript is
    worth acting on (script guard, decode confidence,
    no_speech probability, allowed-language p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
2026-08-09 Extract MicStream into ai/mic_stream.py
    ai/session.py held two large classes with no state in common: the object that
    owns the process's single sd.InputStream and fans blocks out to the wake
    engine, the VAD and the utterance buffer, and the conversation state machine
    that drives it. 417 lines of PortAudio callbacks, decimation, framing and
    watchdog reopen sat in a file whose docstring is about session timers.
    The seam was already there and already good — three callbacks (on_wake,
    on_audio, muted) — which is why this is a move rather than a redesign. The FSM
    was always tested against a FakeMic and the stream was always tested through
    _process_block with no PortAudio; the split just puts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
    [test_mic_stream.py, test_session.py]
2026-08-09 Give the session a public surface on the assistant instead of reaching inside
    ai/session.py called three private members of VoiceAssistant from outside the
    class: _speak_wav (every canned line, every filler line, the wake ack),
    _speak (the live-synthesis fallback when a canned line is missing) and
    _whisper_model (to decide whether a wake can be answered).
    That is not a naming complaint. A leading underscore is the only signal a
    future edit has that a method is safe to change, and all three were load-
    bearing across a module boundary — plus test_session.py's FakeVoice had to
    implement the private names, so the stub was guessing at internals rather than
    implementing a contract.
    _speak_wa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
    [test_session.py, test_voice_assistant.py]
2026-08-09 Update the docs to the module layout that now exists
    The README's File Reference had drifted well before this refactor — it still
    listed voice_assistant.py, session.py, presence.py and laptop_camera.py at the
    top level, i.e. the layout from before ai/, vision/, servo/ and config/
    existed, and pointed at a documents/devcon_primer.txt that was consolidated
    away. Replaced with the real tree, annotated so a newcomer can see which layer
    each package is.
    config/README.md's "Used by" column and four config docstrings pointed at
    face_track.py for knobs that moved: thinking.py's sweep is read by
    app/control_loop.py, tracking.py's REBOOT_ENABLED by web/server.py, voice.py's
    SPEAK_* envelope is buil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
    [servo.py]
2026-08-09 Shape Kai's delivery instead of chasing a better voice model
    The flat-tone complaint survives every knob the voice MODEL has. 29 voices
    across 7 engine families were measured on the Jetson (docs/expressive-voice-plan.md
    on feat/expressive-voice): the shipping voice already has 11.0 st of intonation
    range, and the only model class that models expression is ~0.5B, which OOMs on
    load beside Ollama. What is left is delivery, and that is free from the text side.
    ai/delivery.py shapes the SPOKEN text only, between clean_for_speech and
    clamp_for_speech, so the dashboard still shows what the LLM actually said:
    breaths a break before a clause-initial conjunction in a long run
    opener a discou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
2026-08-09 Stop the same short filler landing twice in one exchange
    Heard on the robot 2026-08-09. Three things had to line up, so all three are
    fixed rather than the one that was easiest to see.
    The lap boundary was unguarded. pick_opener has always excluded the previous
    line; stall_queue had no equivalent, and the session pops from the END of the
    shuffled list -- so when a lap ended the rebuilt queue was free to put the line
    still ringing in the room next out. stall_queue now takes avoid= and rotates
    that key to the front. Rotated, not dropped: dropping would cost the lap a line
    to protect the one gap it is least likely to be heard in.
    One used-set collapsed too early. It is conversation-scoped, so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
    [test_filler.py, test_session.py]
2026-08-09 Let the question set how long Kai's answer is
    Kai's replies were uniformly short regardless of what was asked, and vague on
    exactly the turns that carried the most retrieved facts. Those are two symptoms
    of the same cause, and it was in the prompt rather than in the caps: measured
    replies ran 36-52 tokens against a 96-token ceiling, so nothing was truncating
    them. They were that short because they were told to be, twice.
    persona.txt asked for "1 to 3 short spoken sentences" unconditionally, so a
    greeting and a five-part question got the same budget. It now scales the length
    to the question and says what the upper case looks like.
    ai/rag.format_context repeated the order — "short, warm, s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
2026-08-09 Answer in two or three sentences and offer the rest
    The previous commit fixed the wrong half of the problem. Letting the question
    set the length did make Kai detailed, and on the robot it produced correct,
    well-grounded answers of 118-134 words — a 45-second monologue at someone
    standing in front of him. Detail delivered as a lecture is worse than the short
    version it replaced.
    Kai is talking out loud, so depth belongs on request rather than up front.
    persona.txt now caps every reply at four sentences, puts most at two or three,
    and asks him to give the two or three programs that matter and offer the rest
    ("gusto mo marinig?") instead of reciting all nine.
    The instruction that was actual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
2026-08-09 Retry a killed filler synthesis on the spot, not a pass later
    Second symptom from the robot, 2026-08-09: the short stall opened the turn
    instead of the long line. Not a reordering -- pick_opener returned "" because no
    opener for that language was on disk yet, so the turn fell to the Hmm and went
    straight to the stalls.
    Nothing had been rejected by the length cap. The openers lost the warming race,
    and lost it systematically: 11 failed prewarms across 20 openers (55%) against 5
    across 32 stalls (16%). tts publishes one _synth_proc and stop() kills whatever
    is in it when a turn starts, so an 8 s opener is a far wider target than a 0.3 s
    stall. A killed line then sat out the rest of the pass,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
    [test_session.py]
2026-08-09 Restructure the documentation: overview, changelog, plans, tickets
    README.md had grown to 1207 lines and was carrying five different jobs at
    once: the orientation, the running update log, the full setup guide, the
    tuning reference and the R&D write-ups. Split by the question a reader is
    asking, so each file answers one.
    README.md is now an overview (118 lines) — what Kai is, a quick start, and a
    map. Every section moved to docs/ verbatim, by line range rather than retyped,
    so the prose is byte-identical to what it replaced.
    CHANGELOG.md is new, built from the dated entries that lived in the README's
    TL;DR (2026-06-15 through 2026-08-07). Reproduced verbatim, re-ordered
    newest-first.
    doc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
    [test_voice_assistant.py]
2026-08-09 Round the PD command instead of truncating it
    int() truncates toward zero. Every servo angle is clamped to 0..180 and is
    therefore positive, so that was floor() — a uniform downward bias of up to a
    degree on every commanded angle.
    It did not stop at the wire. app/control_loop.py stores this return value as
    last_pan_cmd and uses it as the slew-clamp reference, the hold-branch anchor,
    and the value pan_pd.reset() re-syncs to when the clamp fires, so the
    truncation fed back into the controller's own state. PAN_DEADBAND is 1 —
    lowered deliberately so that ~1 degree tracking requests are not swallowed —
    which is exactly the resolution at which a sub-degree bias stops being
    invisible.
    self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
    [test_controller.py]
2026-08-09 Cancel speech on shutdown so it cannot outlive the process
    run()'s finally released the mic, Porcupine, MediaPipe, the camera and the
    serial port, but never cancelled speech. Piper and paplay are child PROCESSES,
    not threads: the interpreter exiting does not take them with it. They get
    re-parented and keep playing.
    scripts/autostart.sh relaunches within seconds, so the replacement process
    starts talking over audio the previous one left in the air — and its
    self-hearing gate is wide open, because _last_end and _gate_until know nothing
    about sound started by a process that no longer exists. That is the condition
    under which Kai hears and answers itself. It is also invisible in the log: the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
    [face_track.py, test_session.py]
2026-08-09 Make swallowed retrieval and presence failures visible
    The fail-open policy is right: a broken index must behave exactly as if RAG
    did not exist, and a broken presence feed must never end a conversation. The
    SILENCE was the problem.
    retrieve_context() returned "" for a TypeError, which is indistinguishable
    from "no relevant documents" — and "" is the dangerous state, the one where
    gemma2:2b answers DEVCON questions from its own pretraining rather than from
    the corpus. A whole retrieval regression could ship and present only as "Kai's
    answers got vaguer", with nothing in the log and nothing on /params to point
    at. settings.load() already did this correctly: same blanket catch, but it
    print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
    [test_rag.py, test_web.py]
2026-08-09 Finish capture timeouts off the session lock
    tick() runs its whole body under self._lock, and _lock is an RLock. So the
    code _finish_utterance and _finish_scan carefully place AFTER their own `with`
    block — on the stated grounds that "recording inside the lock would put a WAV
    write on the tick thread" — was still inside tick()'s. Re-entrancy does not
    just permit the nested acquire, it extends the critical section over
    everything the nested method does afterwards.
    That put UtteranceRecorder.record() under the lock on the max_utterance path:
    up to CAPTURE_HARD_CAP_S of 16 kHz mono int16, on the order of a megabyte,
    through wave plus a JSONL append. The audio worker needs that same lock ~3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
2026-08-09 Stop cutting long replies off mid-sentence, and stop the jaw with them
    Two bugs, one symptom: audio stops partway through a sentence while the
    mouth keeps moving.
    STATE_SPEAKING guillotined every reply at 20 s. _enter_speaking armed
    SESSION_SPEAK_MAX_UNKNOWN_S unconditionally, so the backstop against a
    WEDGED paplay was the only deadline a healthy reply ever got --
    SESSION_SPEAK_GRACE_S, commented "allowed overrun past the WAV's own
    duration", reached only the canned branch. The clock also starts before
    Piper does, since on_done fires from the turn worker as soon as the reply
    text exists. TTS_MAX_SPOKEN_CHARS allows 500 characters, ~90 words, about
    31 s at SPEAK_SEC_PER_WORD -- so anything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
    [test_session.py, test_voice_assistant.py]
2026-08-10 Answer how many chapters there are, and agree with ourselves about it
    Asked "how many active chapters are there?", Kai invented a Quezon City chapter,
    hedged "like 3-4 in Luzon", quoted the 60,000-participant reach figure instead,
    and never gave a count. Inventing a chapter is the one thing persona.txt names
    explicitly, but the model was not the whole story: this corpus is Q&A-shaped and
    there was no Q&A pair asking how many chapters there are. The Chapters section
    had where they are, how big they are, and how to start one. A question with no
    entry is a hole retrieval cannot paper over — the nearest chunk lists cities and
    no total, so a 2B model counts the list itself, badly, and fills the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
2026-08-10 Decide what TensorRT is actually for here, before building anything
    The interesting constraint turned out not to be compute. face_track.py holds
    no CUDA context at all today, and the first engine loaded in it creates one
    next to Ollama's pinned 2.4 GB on ~2.0-2.3 GB free. Two things already
    written down say what happens then: the expressive-voice plan measured
    weights + context as the binding term when VoxCPM OOM'd with 3 GB free, and
    latency-plan step 5 documents Ollama silently landing on a half-speed
    CPU/GPU split after fragmentation. So every step here is gated on /api/ps
    placement, not on a stopwatch.
    Only Whisper is worth it, and not for the reason expected: the case is that
    config/vo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
2026-08-10 Write down what would make the conversation land, without the camera
    S12, S13 and S14 are feature specs, not review findings: nothing about the
    current behaviour is broken, it is absent. Noted as such in the index so the
    2026-08-10 review framing stays honest.
    The streaming half of this discussion already had a ticket (R5) and is not
    duplicated here.
2026-08-10 Learn the name of whoever is standing in front of you, and use it
    The prompt is system + capped history + user turn, with no slot for a fact
    about the SPEAKER. So "I'm Jhondel" was an ordinary history turn and
    MAX_HISTORY_TURNS = 6 evicted it six exchanges later, unrecoverably.
    Pin the first name offered and append it to the system prompt. System
    position is the opposite call to RAG_CONTEXT_PLACEMENT and for the opposite
    reason: this string does not vary once learned, so it costs one KV-prefix
    invalidation rather than one per turn.
    Extraction is a regex in the shape of ai/wake_phrase.py, not a second Ollama
    round-trip on the path R5 exists to shorten. Two anchor tiers, because a
    missed nam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
    [test_identity.py, test_session.py, test_voice_assistant.py]
2026-08-10 Capture the name on the one-breath turn too, and say what was measured
    Found on the robot: sess_person stayed empty while Kai replied "Hi
    Jhondel!" — the model had read the name out of the user turn, which looks
    identical from outside and pins nothing. note_identity() was hooked only
    into _process(), but the one-breath hands-free turn runs through say(),
    since the whisper wake tier already holds the transcript. The same sentence
    captured or did not purely on whether the speaker drew breath.
    Gated on use_llm so the verbatim /voice/say route cannot make Kai believe it
    is talking to itself.
    Also correct the KV-prefix comment. It predicted a one-turn prompt_eval
    spike as though that were est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
    [test_voice_assistant.py]
2026-08-10 Let Kai breathe, and give it a room to speak in
    Four Piper and sox parameters that were never being passed, found by reading
    `python3 -m piper --help` on the robot rather than trusting the code's own
    assumptions about what it was sending.
    The one that mattered: `--sentence-silence` defaults to 0, so a four-sentence
    reply was spoken as one continuous run. Measured at the three sentence
    boundaries of the same reply, 0.20/0.17/0.14 s before and 0.59/0.56/0.54 s
    after — conversational speech leaves 0.4-0.7 s. `ai/delivery.py` had already
    been tuned to buy a 0.156 s breath *inside* long sentences while the boundary a
    person leans on hardest got nothing.
    The one that did not: `noise_scale` and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
    [face_track.py, settings.py, test_delivery.py, test_settings.py, test_tts.py]
2026-08-10 Say what Kai actually runs on, not Micro:bit and Qwen
    Asked what powers it, Kai read back "Claude Code, Micro:bit, Qwen, Google AI
    Suite, and NVIDIA" -- verbatim from the kai-stack entry, which wins that
    question on SECTION_BOOST's +0.08 for "Kai (robot)". Retrieval was working
    correctly; the document was wrong. Three of those five are things this repo has
    never used, and the entry contradicted its own neighbour kai-hardware two lines
    up, which correctly says "no cloud round trips".
    The entry now names the real stack -- Jetson Orin Nano, MediaPipe, Whisper,
    Gemma 2 via Ollama, Piper, an Arduino on the servos, and the local fastembed
    index -- and stays speakable: "Gemma 2", not gemma2:2b.
    s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
2026-08-10 Enforce the servo travel limits where a corrupt wire cannot undo them
    SERVO_MIN/SERVO_MAX (10/170) protect the Tower Pro SG90 from overshooting into
    its mechanical stop, and only the host applied them. The sketch constrained to
    the full 0..180 in all three constrain() calls, so the limit held exactly as
    long as every byte on the wire arrived intact.
    The link is fire-and-forget by design -- no checksum, no echo, no ack -- so the
    host's clamp is applied and then destroyed in transit with nothing downstream
    able to tell a mangled line from a real one. String::toInt() made that worse
    than a dropped command: it returns 0 for "", for "J", for line noise, and 0 here
    is not an inert default but a h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
    [servo_serial.ino, test_servo.py]
2026-08-11 Wait for the next frame instead of polling 200 times a second for it
    CameraThread.latest() is non-blocking and returns None until a fresh frame
    arrives, so face_track.run() slept NO_FRAME_SLEEP (5 ms) and went round again.
    With --no-camera, an unprobed camera, a stalled feed, or simply between frames at
    30 fps, that is ~200 iterations a second -- each doing real work before deciding
    there was nothing to do: a settings.get() under an RLock, a speaking_openness()
    call taking the assistant lock, a time comparison.
    All of it holds the GIL, and config/tracking.py records the GIL as the resource
    this box actually runs out of: raising perception 15 -> 22 fps collapsed the
    pure-Python control threa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
    [face_track.py, test_camera.py, test_settings.py]
2026-08-11 Build the /params snapshot once for all tabs, not once per tab
    Each connected browser gets its own Flask generator thread calling
    params_snapshot() 20 times a second, and that builds a ~70-key dict from four
    sources. One of them, session.get_status(), holds the session RLock for most of
    its body and takes the assistant lock inside it -- the same RLock the ~30
    blocks/s audio worker needs for VAD and the 20 Hz session tick holds. So the cost
    scaled linearly with open tabs, on the locks the robot needs most, and two or
    three tabs at a venue is a realistic load that had never been tested.
    It was also pure overhead: the publishers write at 25 Hz, so most of that work
    produced JSON byte-identical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
2026-08-11 Cover the module that decides whether Kai has a camera
    app/camera_supervisor.py was the only substantial module in the repo that no test
    imported. Its own docstring has advertised testability since it was written --
    "it knows about vision/ and settings.py; it does not know about Flask, MediaPipe
    or the servo, so it can be driven with a fake camera and a fake clock" -- and
    nothing took it up.
    The untested logic is where the recorded bugs are. Depth 3 on the swap queue
    exists because a depth-1 one silently evicted a swap CameraThread had not applied
    yet. The showing_live gate on the stall check exists because a stalled CSI
    pipeline was reported as a live feed at 0 fps. The cheap = not device_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
    [camera_supervisor.py, test_camera_supervisor.py]
2026-08-11 Compile and flash R4, and correct the claim that we could not
    The earlier note said "no Arduino toolchain was available on either box, so the
    C++ is reviewed but unbuilt". That was wrong twice over: the check ran on the
    Windows dev box rather than the robot, and it searched for gcc-avr, which is a
    Debian package name and never a binary -- the binary is avr-gcc. The Jetson has
    had avr-gcc, avr-g++, avrdude 6.3, arduino-builder 1.3.25 and arduino-core-avr
    1.8.4 the whole time, with the Servo library in ~/Arduino/libraries. Nothing was
    blocking this but a bad search.
    Built: zero warnings under -warnings all, and SMALLER than what it replaces --
    6122 bytes against 6262, because parseAngle() cos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
2026-08-11 Have Kai say what she runs on when she wakes up
    The startup greeting named Kai and taught the wake phrase, but said nothing
    about the thing people at a demo table actually ask about ten seconds later:
    a cardboard face does not look like it is doing anything locally, and running
    entirely on-device is the whole point of the build.
    Phrased the same way as the loud-room filler in config/filler.py so the two
    unprompted lines cannot drift into contradicting each other.
    Costs roughly three extra seconds of boot audio, which is dead air while the
    filler bank is still cold. Paid once per process; noted in the comment.
2026-08-11 Make a long filler sit out two exchanges before it repeats
    The once-per-conversation set only covers the first lap through a
    language's openers; after that the only guard was a single-entry
    back-to-back check, so the four-line ceb and en pools could settle into
    A B A B for the rest of a conversation.
    FILLER_OPENER_COOLDOWN_TURNS = 2 keeps the last two openers, so the
    tightest recurrence is A B C A. When the window outgrows the warm pool
    _off_cooldown relaxes it one exchange at a time, oldest bar first — a
    flat fallback to the whole pool would hand back the line that just
    played, which is the bar that matters most.
    [test_filler.py]
2026-08-11 Stop capturing the speaker's own card, and stay quiet when a relaunch already greeted
    The startup greeting was heard twice a minute apart because face_track segfaulted
    at its first playback and autostart.sh relaunched it. Two fixes for one symptom.
    SPEAKER_CARD_NAME_HINTS drops input devices that sit on the speaker's card from
    the candidate list entirely: capturing them raw while tts.play() reconfigures that
    card with pactl is what took the process down. The fallback is the pulse-mediated
    default, which is safe where a raw open is not.
    _greeted is a per-instance latch and cannot see a different process, so the fact
    is now also stamped at GREETING_STAMP_PATH, written before the audio starts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
    [test_mic_device.py, test_session.py]
2026-08-12 Wait for the sound before moving the jaw, and stop at the word not the file
    "Hey Kai" was answered by a mouth that moved first, with the "Yes?"
    arriving afterwards. Two errors, both at the start of the file, both
    pushing the same way:
    tts.play() does not make sound, it spawns paplay — the first sample is
    ~0.2 s behind it (Buffer Latency 57-120 ms plus Sink Latency 63-98 ms,
    sampled with pactl through a 5 s playback). The jaw window opened at the
    call. It now opens at now + TTS_PLAYBACK_LEAD_S.
    And Piper pads silence onto both ends, so the 0.824 s ack holds 0.54 s of
    "Yes?" — the jaw mimed across all of it, hanging open a quarter-second
    past the sound. tts.wav_speech_span() finds the au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
    [test_tts.py, test_voice_assistant.py]
2026-08-12 Speak Bukidnon and Iligan Bisaya, not Cebu Bisaya
    The ceb filler bank named a Cebu City street and carried four grammar
    errors that mark it as written by a non-speaker. DEVCON's active
    chapters are Bukidnon and Iligan; Cebu is a separate chapter.
    All four openers and one stall corrected, and the two things that look
    like mistakes but are not -- the gina- progressive and huwat for
    hulat -- written down in the file so they survive the next tidy-up.
    Measured on the robot: openers 7.06-8.69 s under the 10 s cap, stalls
    0.88-1.61 s under 1.8. filler_check scores the whole bank 0.00 including
    the lines this did not touch, which is Whisper's limit on Bisaya, not
    the lines'; nothing was spelled ou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
2026-08-12 Run a third lens over the codebase, and write down what it found
    The 2026-08-10 review looked through a robotics and a software lens. Running an AI
    engineering lens alongside a re-run of those two agreed with all three existing
    ratings and raised five tickets: A1-A4 and R11.
    Its framing note is that the AI subsystem is where this codebase stops applying its
    own comment-as-measurement discipline to the thing being changed. Retrieval is
    measured carefully; the generated reply is not measured at all. That is A2, and the
    other four each depend on it or on each other, so the index records the ordering
    rather than leaving it to be rediscovered.
    The reviewer agent itself is checked in beside the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
2026-08-12 Say in the PRD that Kai runs untethered, and off a powered speaker
    Three things the document still listed as pending have since happened on the robot,
    and the PRD was the last place still describing the old state.
    The 20V powerbank is no longer the physical blocker to an untethered demo; Kai runs
    a full session off it with no wall power, so AC-15 is added and the powerbank risk
    is restated as a runtime question rather than a can-it-work one.
    The PAM8403 amplifier and cavity speaker are out, replaced by a powered USB speaker
    on the dongle's 3.5mm jack. Same audio path, one self-contained unit instead of an
    amp board and loose wiring, which is also most of the reason the housing task
    existed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
2026-08-12 Check in the hardware build sheet, rev D
    The wiring, pin mappings and physical layout have lived outside the repository until
    now: the INMP441 to 40-pin I2S2 mapping, the two SG90 signal pins, the body drum
    coordinates, the power and ground scheme, and the pre-power checklist. None of that
    is recoverable from the code, and S11's note about the I2S microphone pinout not
    being written down anywhere is the case for having it here.
    Rev D is checked in as it stands, and two of its claims are known to be behind the
    rest of the record:
    - The audio chain is given as C-Media -> 3.5mm -> PAM8403 -> speakers, in the TL;DR,
    the drum coordinates, the 5V-audio rail and two checklist items. The PAM8403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
